cnpem-emi/reflow-oven-hw/README.md

# reflow-oven-sw
This repository severs to recording hardware versions

#### 1 - new
    working in schematic and PCB prototype... 

#### 2 - old
    depreciated, as the thermoresistor pt100 does not support high temperature
