cnpem-emi/reflow-oven-hw/schematic-mbed.png

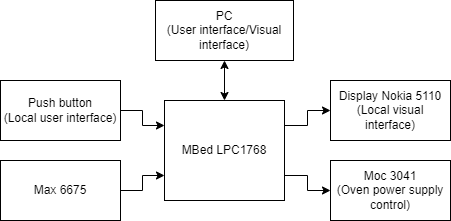
schematic-mbed.png
