cnpem-emi/reflow-oven-hw/schematic-user-interface.png

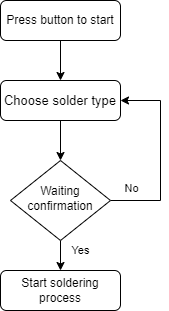
schematic-user-interface.png
