cnpem-emi/reflow-oven-hw/(commit log)

2022-08-15 V0.3 added display nokia connections5510 and max6675
    [reflow-oven-v0.1.kicad_pcb, reflow-oven-v0.1.kicad_sch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]
2022-08-16 added schematic image
2022-08-17 Updated cad schematic *added pwm pinout extra
    [reflow-oven-v0.1.kicad_sch]
2022-08-18 Adjusted postion of eletronic components and added push buttons into cad schematic file
    [reflow-oven-v0.1.kicad_pcb, reflow-oven-v0.1.kicad_sch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]
2022-08-19 Added PCB schematic for prototyping
    [reflow-oven-v0.1.kicad_pcb, reflow-oven-v0.1.kicad_sch]
2022-08-19 Update schematic
    [reflow-oven-v0.1.kicad_pcb, reflow-oven-v0.1.kicad_sch]
2022-08-22 Adjusted kicad schematic
    [reflow-oven-v0.1.kicad_pcb, reflow-oven-v0.4.kicad_pcb, reflow-oven-v0.4.kicad_sch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]
2022-08-22 Adjusted copper of board
    [reflow-oven-v0.4.kicad_pcb, reflow-oven-v0.4.kicad_sch]
2022-08-23 Added gabers files
    [reflow-oven-v0.4.kicad_pcb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]
2022-08-23 Update PCB schematic and Gaber files
    [reflow-oven-v0.1-B_Cu.gbr, reflow-oven-v0.1-Edge_Cuts.gbr, reflow-oven-v0.1-F_Cu.gbr, reflow-oven-v0.1-PTH.drl, reflow-oven-v0.4-B_Cu.gbr, reflow-oven-v0.4-Edge_Cuts.gbr, reflow-oven-v0.4-job.gbrjob, reflow-oven-v0.4.drl]
2022-08-29 Fixed ground connections in PCB schematic
    [reflow-oven-v0.4.kicad_pcb]
2022-09-22 Updated schematic
    [reflow-oven-v0.4.kicad_pcb, reflow-oven-v0.4.kicad_sch]
2022-10-13 Added some improved discussed in the meeting
    [reflow-oven-v0.4.kicad_sch]
2022-10-14 Updated schematic and added frootprint
    [reflow-oven-v0.4.kicad_sch]
2022-10-17 Updated frootprint
    [reflow-oven-v0.4.kicad_sch]
2022-10-19 Updated part AC
    [reflow-oven-v0.4.kicad_sch]
2022-10-19 Added mbed footprint
2022-10-19 Updated PCB schematic
    [reflow-oven-v0.4.kicad_pcb, reflow-oven-v0.4.kicad_sch]
2022-10-25 Updated all schematic
    [reflow-oven-v0.4.kicad_pcb, reflow-oven-v0.4.kicad_sch]
2022-10-25 Fix retangle line
    [reflow-oven-v0.4.kicad_sch]
2022-10-26 Fixed schematic
    [reflow-oven-v0.4.kicad_pcb, reflow-oven-v0.4.kicad_sch]
2022-10-26 Fixed GND scheme between back and front face
    [reflow-oven-v0.4.kicad_pcb]
2022-10-26 Fixed drawn rules
    [reflow-oven-v0.4.kicad_pcb]
2022-10-27 Fixed GND
    [reflow-oven-v0.4.kicad_pcb, reflow-oven-v0.4.kicad_sch]
2022-10-27 Change R2 from SMD to PTH and added fixing holes
    [reflow-oven-v0.4.kicad_pcb, reflow-oven-v0.4.kicad_sch]
2022-10-28 Generated gaber files
    [reflow-oven-v0.4.kicad_pcb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]
